tejaswa4692/EfficientFlyingWing/README.md

# Long range spy Autonomous wing for battlefield mapping

This is my custom designed Autonomous FPV flying wing from scratch using my own wing manufacturing process and 3D printing

I am aiming to achieve 7A of cruise draw, while at 45kmph speed, i think hitting the speed record is gonna be one of the hard things in this challenge

The design is a conventional flying wing with a swept wing design, i gave 3 degrees of washout at wingtips, the design uses MH45 Airfoil for both root and tip chord

I will also be custom tuning the FC and releasing the files for it for ease of use

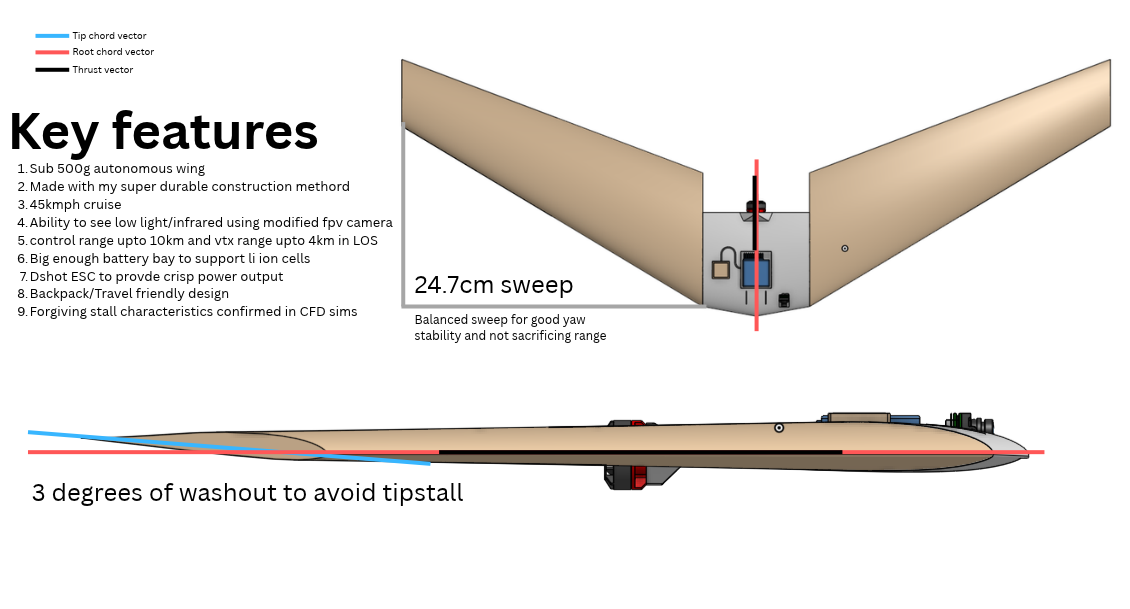
[picture p1: assets/1.png]


The root of the usable wing surface is 20cm and the tip is 10cm, sweep distance is 27cm with 98cm wingspan, so we can safely assume this is a 1000mm swept wing platform

I have confidence in this design as i studied why my old wings didnt fly and it was because the center of pressure of the wing was way too close to the COG and it didnt provide any stability of any sorts (the cog for this wing is marked under the 3D printed fuselage)

How this design is unique to others available on the internet is this is one of the most durable wings, Online wings are either 3D pritner or are SUPER expensve to build, This one achieves everything it aims as less as possible

# Sim testing

I have ran CFD sims on this design to confirm my deisng choices, and with what i saw i nailed it 

### The tip

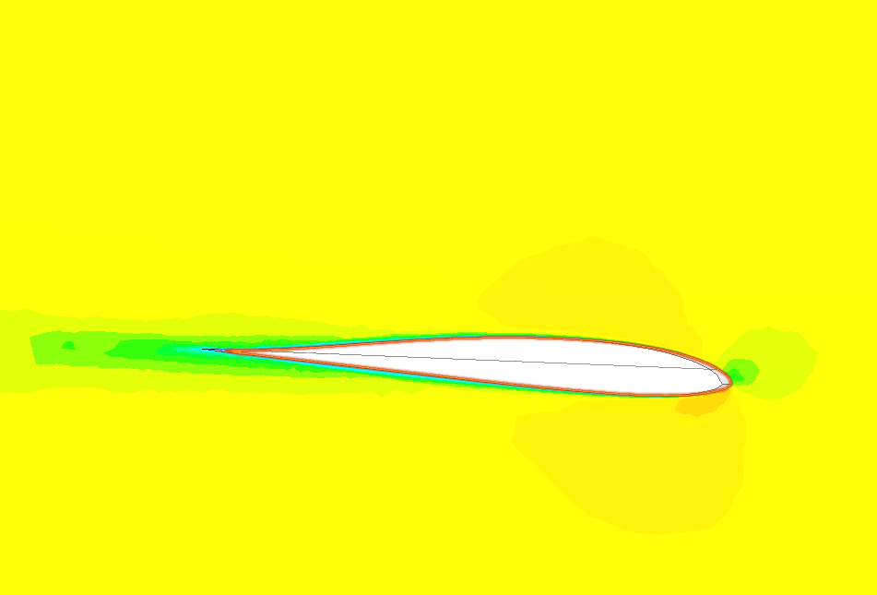
[picture p2: assets/2.png]


As we can see, on level flight the tip is facing downwards, hence its angle of attack is much lower than the root which is shown in the next image

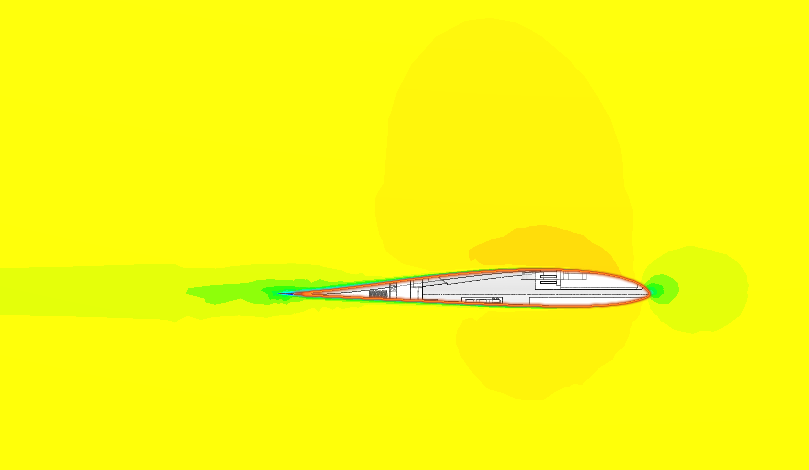
[picture p3: assets/3.png]


This ensures that when the aircraft is aggressively pitched up, the tips of the wings stall at last, this ensures the aircraft maintains a super forgiving stall and the pilot will have PLENTY of time to react to it and save it

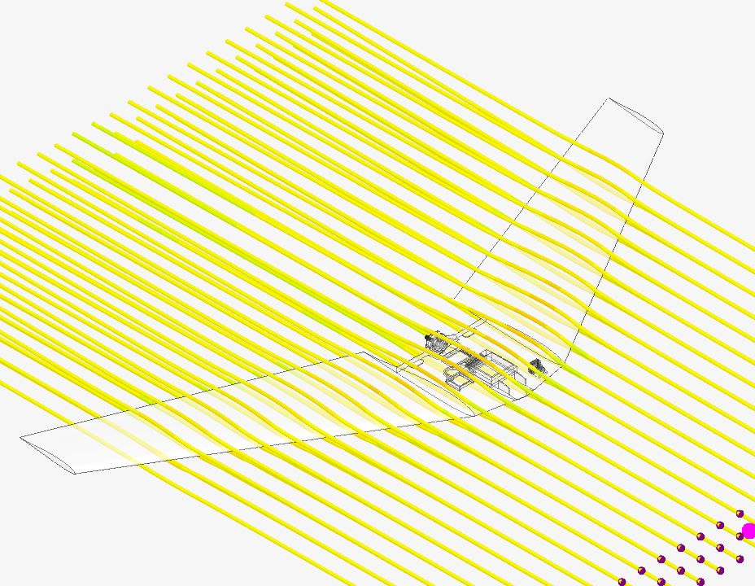
[picture p4: assets/4.png]


wind tunnel testing of this aircraft also shows that this is aerodynamically well designed and drag will indeed be reduced, this along with the pusher configuration is gonna make the cruise super efficient

# Tech stack

I will be using emax rs2205 motor for the main propulsion unit, with a 6045 triblade props that i have lying around

It will all be controlled by radiolink crossflight FC which will be flashed with INav or Ardupilot, I will then use Mavlink over ELRS to get telemetry to my laptop and this wing can be used to fly autonomous missions

I have a dakefpv 1W vtx connnected to a ms mini 1000tvl camera which will be responsible for broadcasting video to my gsc

## Heres the wiring diagram for the wing

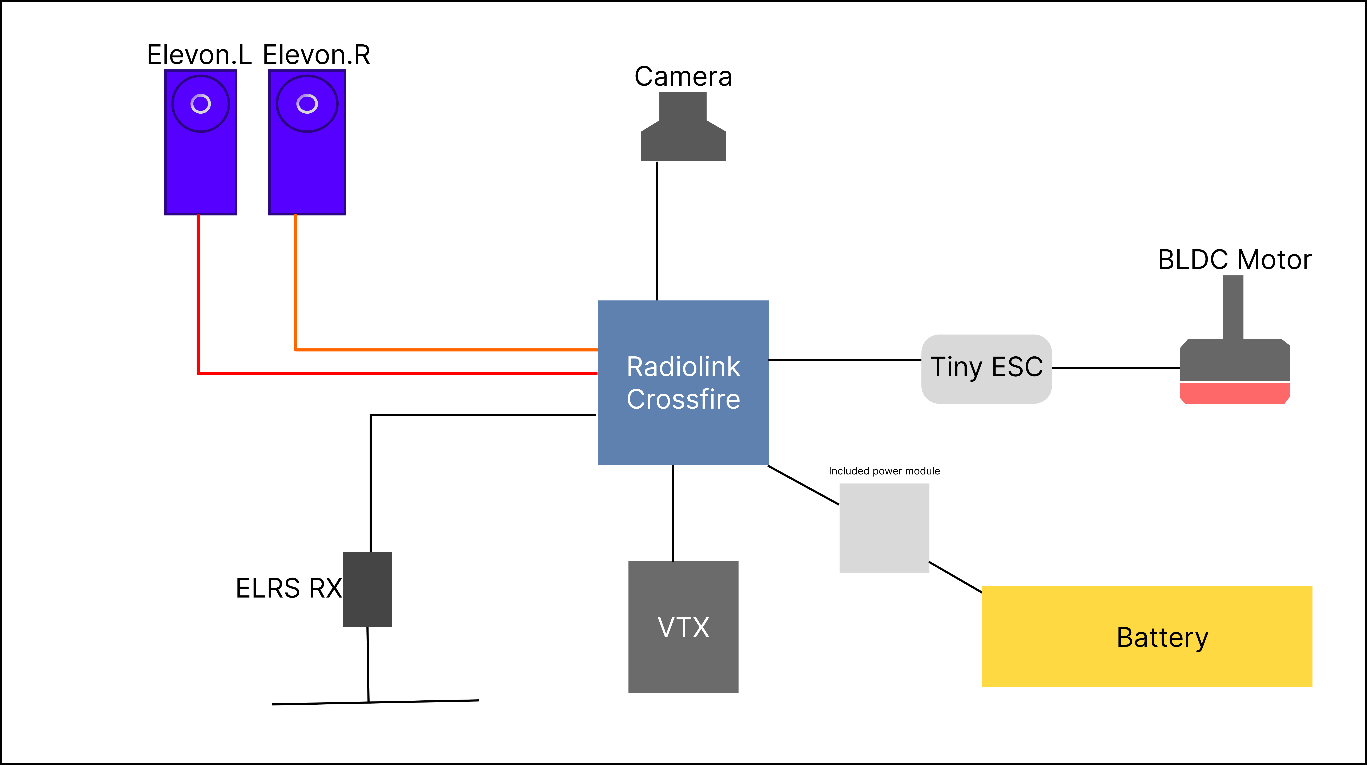
[picture p5: assets/5.png]


# 3D printable files

the only files needed to be printed are the betterservolink and flyingwing3dpirnt files that are in CAD folder of the repo

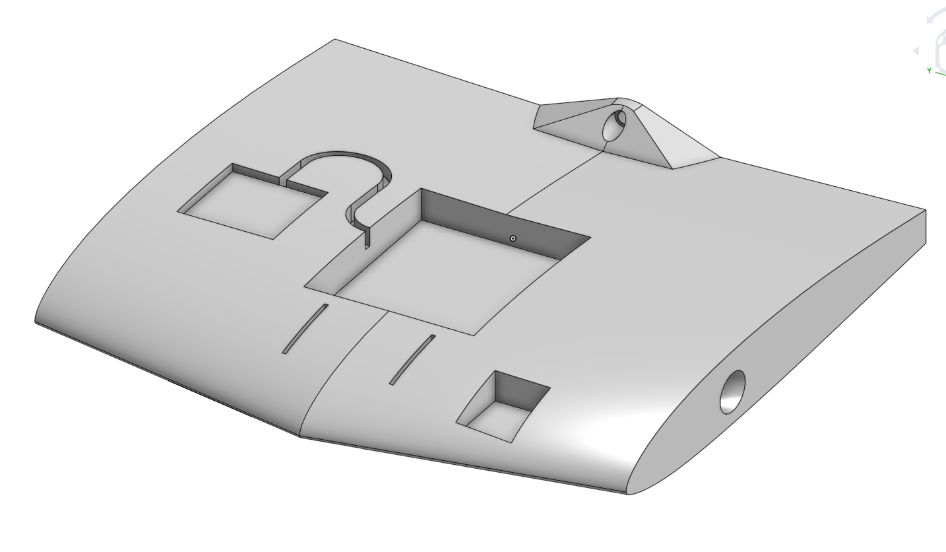
[picture p6: assets/3dprint.png]


# Wing build process

1. Cut out the templates of the airfoil out of cardboard
3. Use CA glue to reinforce the cardboard and stiffen up the edges
4. sand the edges of template so hot wire slides much smoother
5. take a sheet of thermocol and on the side place the 2 templates you cut out and put them
6. Place one of the template 27 cm behind the first root template to get the sweep, and make sure to account for mirror effect when making the other wing
7. wrap nichrome wire around 2 nails with approx 55cm distance between them attach the power wires on nails and power it using a powersupply (i used my old laptops 19V 2.5A supply)
8. slowly cut out the 45cm wing section out of the thermocol, dont worry if u dont nail it first try
9. Repeat this 1 more times to get total wing length of 100cm
10. Now cut your paper bag in approx 22.5cm sections
11. Cover a part of your wing with the mixture of craft glue + water and then place your piece of paper over it, make sure there are no airbubbles under the wing, do this for all around the wing
12. cut strips of 5cm and place it on the seams of the paper you laid down before
13. wait for your wing to completely dry before moving on

#After installing all the electroncis and stuff your assembly should look like this 

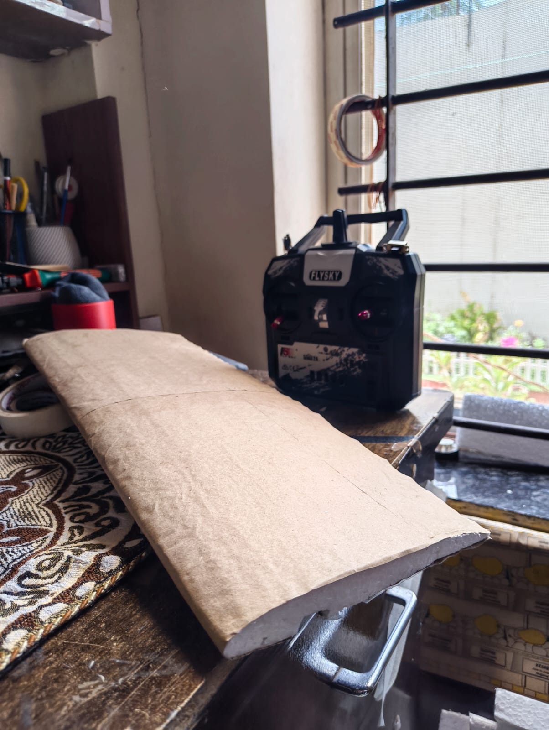
[picture p7: assets/image.jpeg]


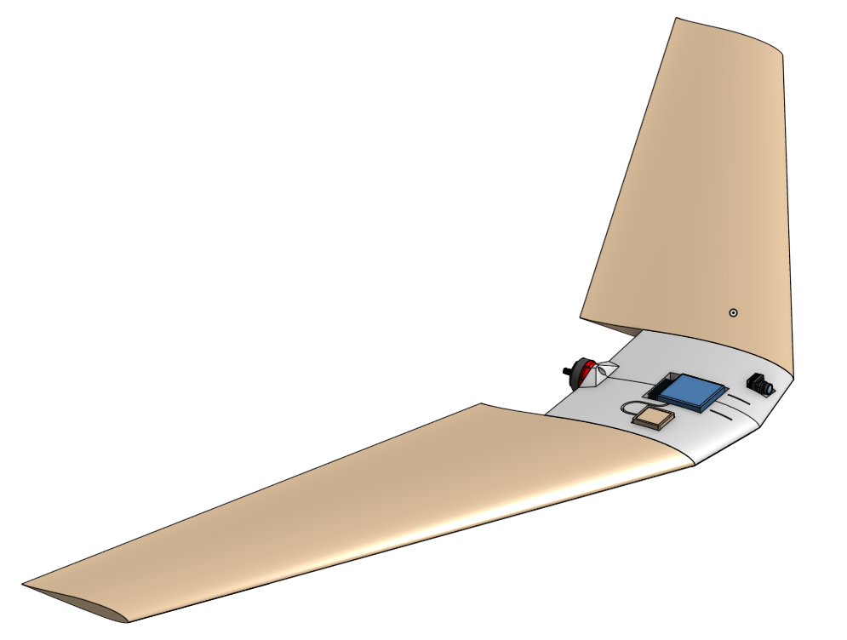
[picture p8: assets/assembly.png]


# Goals to achive
1. I want to attain hands off BLOS autonomy with this design with no user control necessary
2. The design must cruise slow enough for spying purposes
3. Cruise draw MUST be under 7A
4. Cruise speed can roughly be around 45kmph
5. The aircraft must be stable and tuned perfectly to ensure no faults during BLOS flights

# Onshape link
https://cad.onshape.com/documents/3d392902670710a880efa328/w/26a4caf5453043c9f88016e0/e/99eee52926858585e8632edb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

# CFD Sim link 

https://www.simscale.com/projects/tejaswa7692/flying_wing__246632335
