tejaswa4692/EfficientFlyingWing/assets/Screenshot_20261028_222852.png

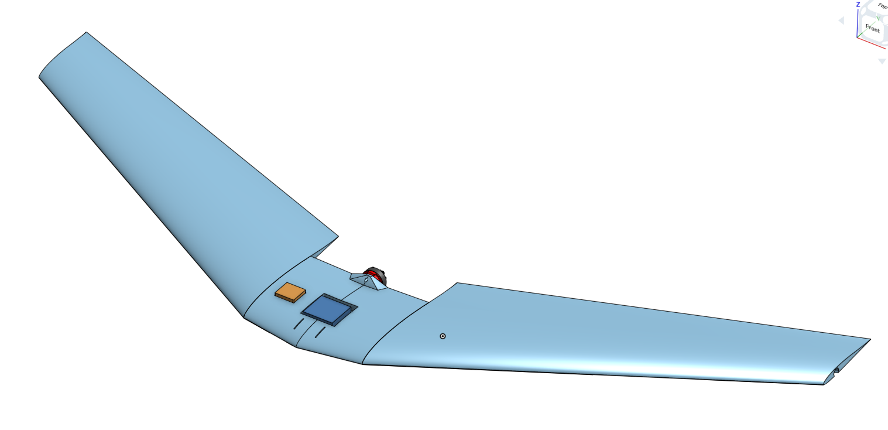
assets/Screenshot_20261028_222852.png
