tejaswa4692/EfficientFlyingWing/assets/Screenshot_20261028_222913.png

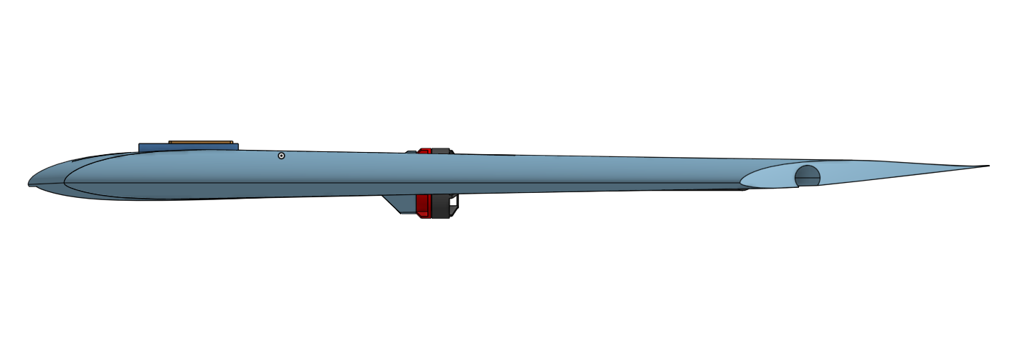
assets/Screenshot_20261028_222913.png
