tejaswa4692/EfficientFlyingWing/BOM.csv

Item Name | Qty | Price (total) (USD) | Item link | Notes
RS2205 BLDC | 1 | $6.70 | https://hitechxyz.in/products/rs2205-2300kv-4s-brushless-motor-for-5-inch-fpv-drone-cw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 | a 2205 motor i have experince with and can spin the 6 inch prop good
Servo motors | 2 | $3.15 | https://robocraze.com/products/mg90s-servo-motor?_pos=5&_sid=a6d339cb7&_ss=r | 2 Servo motors, one for each control surface
Paper bags | 4 | Trash | Trash | Dumpster diving
Radiolink crossfire FC | 1 | $64.51 | https://hitechxyz.in/products/radiolink-crossflight-flight-controller-for-drones-and-uavs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 | The cheapest UAV FC that supports my fav firmware (ardupilot)
MS MINI Camera | 1 | $10.00 | https://hitechxyz.in/products/ms-mini-1800tvl-high-quality-1-1-8-cmos-2-1mm-lens-analog-fpv-camera-black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 | FPV Camera
Dakefpv VTX | 1 | $19.93 | https://hitechxyz.in/products/dakefpv-5-8ghz-1w-analog-video-transmitter-vtx-for-fpv-drone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 | a tiny 1W vtx
Speedybee ELRS rx | 1 | $12.00 | https://hitechxyz.in/products/speedybee-nano-2-4g-expresslrs-elrs-receiver-1?_pos=5&_sid=e133b47b1&_ss=r | ELRS reciever (i use radiomaster pocekt)
Thermocol sheets | 2 | trash | trash | dumpster diving
M10 GPS | 1 | $15.00 | https://hitechxyz.in/products/spartk-sk-252q-m10-gps-module-with-qmc5883l-compass-for-fpv-drone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 | Great GPS module ive used this before
tiny ESC | 1 | $6.50 | https://hitechxyz.in/products/favourite-littlebee-30a-2-6s-dshot-esc-for-drone?_pos=1&_sid=c42d88cbe&_ss=r | Tiny ESC, pomises Dshot?!?!!?!?
RHCP antenna | 1 | $5.25 | https://hitechxyz.in/products/lollipop-v4-5-8g-rhcp-100mm-sma-fpv-antenna?_pos=14&_sid=8d11dc1a0&_ss=r | RHCP anteanna, matches my reciver
500mm CF tubes | 2 | $7.85 | https://robu.in/product/carbon-fiber-tube-hollow10mmod8mmid500mml-twill/ | CF tubes for wing spar
PLA basic filament | 1 | $0 | Ill get this myself | This will cover for the crashes for aircraft
Battery |  | I liek planes i already have
Props | 1 | I already have
Stainless steel wire | 1 | I already have |  | To make the control links
Little extra headroom (will return, but its only there cuz idk what accurate delivery charges are) |  | $5.25
Total Price (USD): | $155.89
