tejaswa4692/EfficientFlyingWing/CAD/AssemblyWithElectronics.step

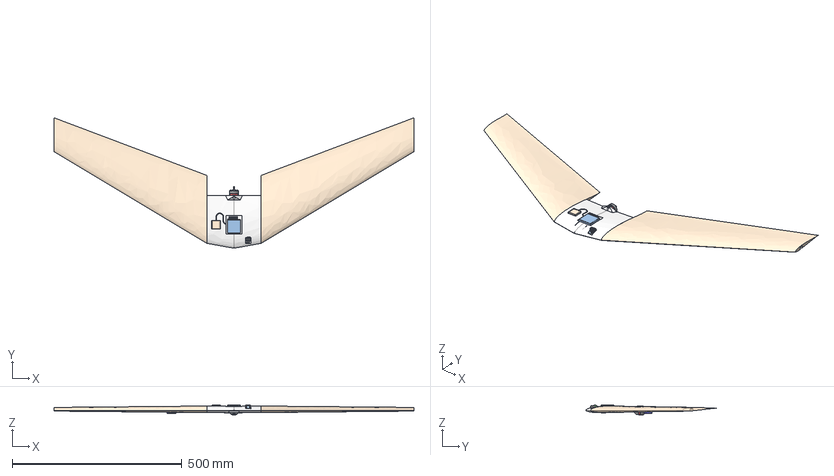
[picture p11: CAD file, 2026-11-12]
CAD/AssemblyWithElectronics.step
1060.0 x 384.2 x 30.8 mm
shaft_Varsay�lan
motor upper part_Varsay�lan
motor lower part_Varsay�lan
CFTube x 2
CADDX BABY RATEL 2 CAMERA
little bee-1-solid1
Crossfire
