tejaswa4692/EfficientFlyingWing/CAD/CFDAssembly.step

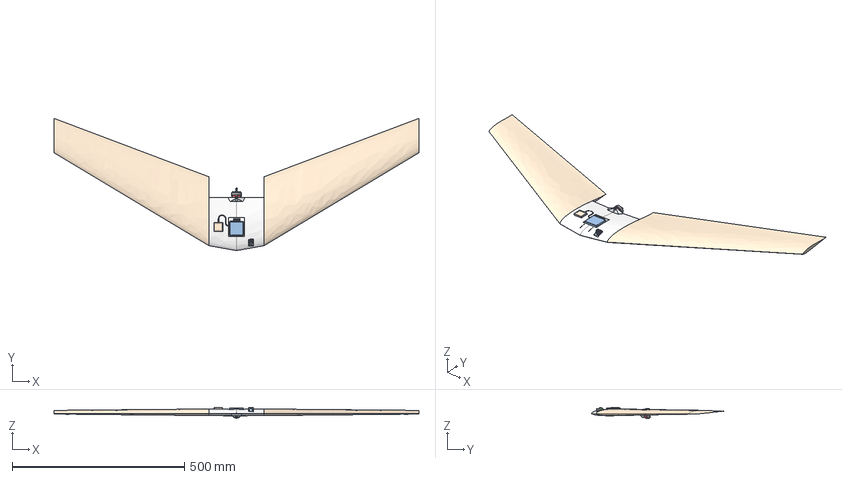
[picture p12: CAD file, 2026-11-11]
CAD/CFDAssembly.step
1060.0 x 384.2 x 30.8 mm
shaft_Varsay�lan
motor upper part_Varsay�lan
motor lower part_Varsay�lan
CADDX BABY RATEL 2 CAMERA
Crossfire
little bee-1-solid1
