tejaswa4692/EfficientFlyingWing/CAD/Better_Servo_Link.step

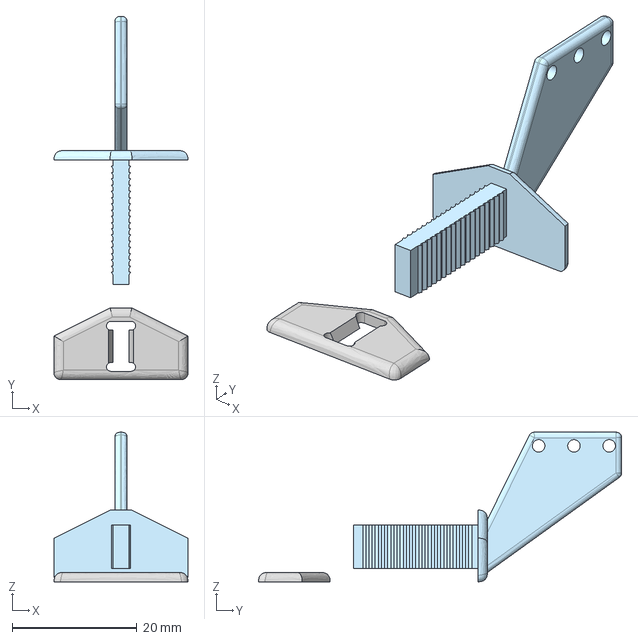
[picture p13: CAD file, 2026-10-29]
CAD/Better_Servo_Link.step
21.5 x 58.2 x 24.0 mm
