tejaswa4692/EfficientFlyingWing/CAD/FlyingWing3Dprint.step

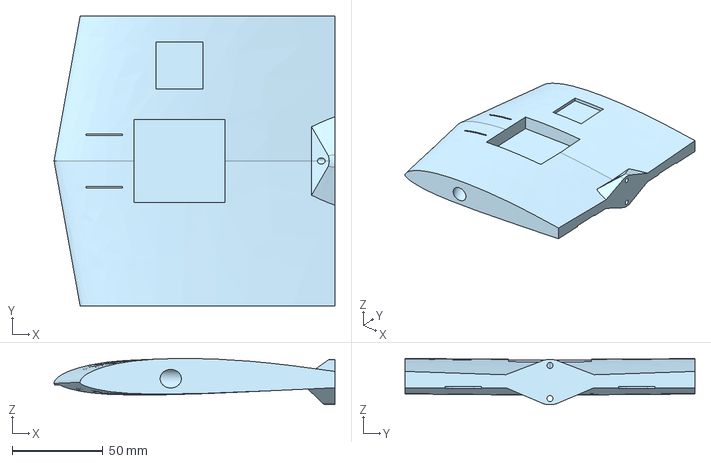
[picture p14: CAD file, 2026-10-29]
CAD/FlyingWing3Dprint.step
155.0 x 160.0 x 25.6 mm
