tejaswa4692/EfficientFlyingWing/(list of files, cad)

Other CAD files:
CAD/FlyingWing.step
CAD/Better_Servo_Link.3mf
CAD/FlyingWing3Dprint.3mf
