tejaswa4692/EfficientFlyingWing/JOURNAL.md

---
title: "Super Efficient FPV Wing"
github: "https://github.com/tejaswa4692/EfficientFlyingWing"
description: "An autonomous flying  wing that i will optimize for super long flight times "
created_at: "2026-10-08"
total_time: "10h 18m"
---

# October 9, 2026: Started the design
<!-- fabricate:entry 215 -->

Started the initial design process figured out how ill be achieving this, off camera i ran some numbers to figure out correct weight estimates for these motors, wing loading looks pretty promising

Timelapse: https://lapse.hackclub.com/timelapse/K82-IBiA1aFh

**Total time spent: 48m**

# October 10, 2026: Made the 3D printable shell
<!-- fabricate:entry 321 -->

Made the 3D printable shell and started works on the servo motor tilt Vtol mechanism, also ive added the electroncis im gonna be using to the cad model too



Timelapse: https://lapse.hackclub.com/timelapse/NyxLOWQaWjFF

**Total time spent: 1h 30m**

# October 18, 2026: Working on motor mount
<!-- fabricate:entry 626 -->

I started the design iteration proess for a good motor mount for this Vtol, its lowk kinda hard to figure tis out but ill figure it out

Timelapse: https://lapse.hackclub.com/timelapse/3qHFGSChsqty

**Total time spent: 1h 18m**

# October 28, 2026: Changing the design to a flying wing
<!-- fabricate:entry 1468 -->

Ive made a lot of conventional tail aircrafts that fly, but my flying wings have never flown, so im gonna take on this challenge and conquer the skies with flying wings now

Timelapse: https://lapse.hackclub.com/timelapse/GY8Co9ZK9c66

**Total time spent: 1h 48m**

# October 28, 2026 (entry 2): Finished the flying wing design process
<!-- fabricate:entry 1478 -->

Finished the flying wing design process, made sure the center of pressure is behind COG this time not making thta dumb mistake again, Getting the CF tube angle right was a nightmare but i was able to  do it : D

Timelapse: https://lapse.hackclub.com/timelapse/-YE5GOiDyCon

**Total time spent: 1h 36m**

# October 29, 2026: Finalised the design
<!-- fabricate:entry 1506 -->

Finished the wing design process, went over the BOM multiple times and wrote the docs for the repo aswell, just gonna do some final checks before i ship

Timelapse: https://lapse.hackclub.com/timelapse/cs-mQqA6DQDO

**Total time spent: 1h 30m**

# November 9, 2026: Polishing
<!-- fabricate:entry 2485 -->

Made the 3d model for components properly this time not just rects, designed a tiny poster that shows my design choices for this wing, ran CFD sims to back my design choices aswell




Timelapse: https://lapse.hackclub.com/timelapse/aJCF_8N3f82p

**Total time spent: 1h 30m**

# November 12, 2026: Documentation
<!-- fabricate:entry 2673 -->

Documented the updates, updated the BOM a lil too, added CFD sim links to the readme and added the cool poster aswell

Timelapse: https://lapse.hackclub.com/timelapse/KleVnaiw7Xy2

**Total time spent: 18m**
