tejaswa4692/EfficientFlyingWing/(commit log)

2026-10-29 here yall go
    [Assembly.step, BOM.csv, Better_Servo_Link.3mf, Better_Servo_Link.step, FlyingWing3Dprint.3mf, FlyingWing3Dprint.step]
2026-10-29 Initial commit of README for FPV flying wing project
    Added detailed project description, specifications, and tech stack for the custom FPV flying wing.
2026-11-12 Clarify wing design as Autonomous FPV flying wing
    Updated the description to clarify that the wing is autonomous and added details about the center of gravity.
2026-11-12 fabricate buggin
    [AssemblyWithElectronics.step]
